Pongkemon01/Embedded-Thruster-Control-and-Monitor-System/README.md

# Embedded-Thruster-Control-and-Monitor-System
