Pongkemon01/Embedded-Thruster-Control-and-Monitor-System/circuit/etcam/etcam.kicad_pcb

## KiCad design circuit/etcam/etcam.kicad_pcb (2020-01-25)

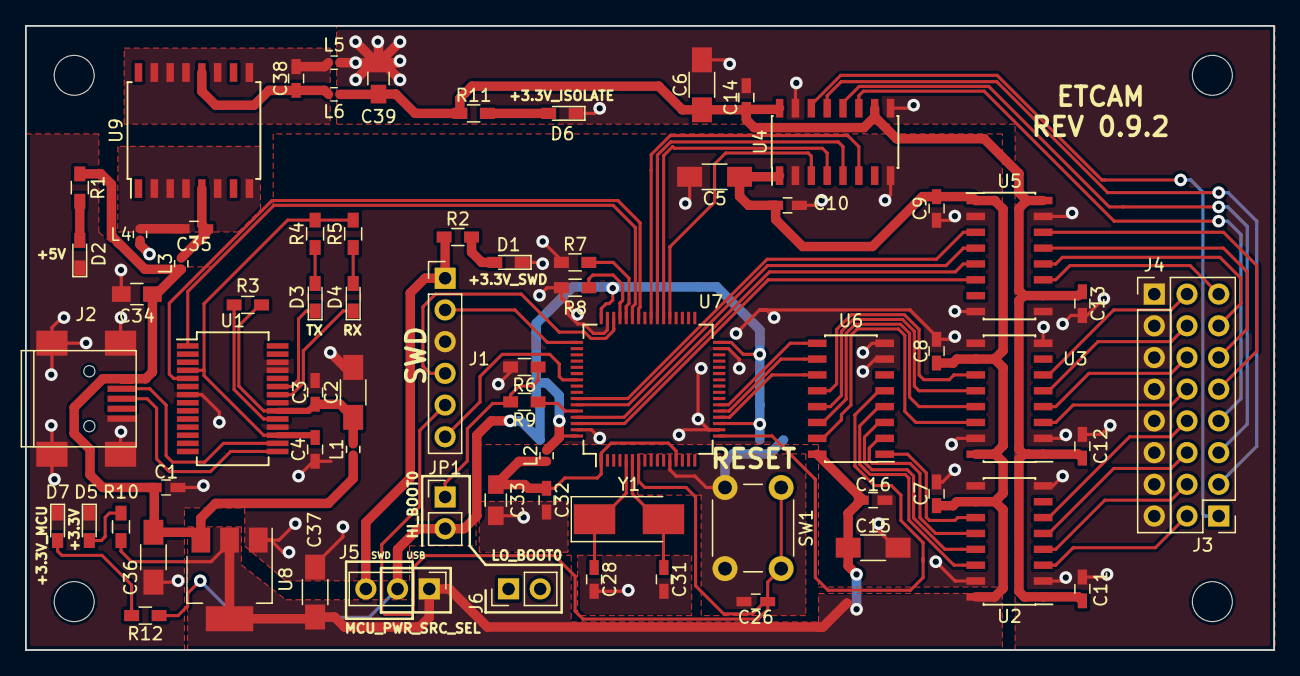
[picture p1: board etcam.kicad_pcb from above]

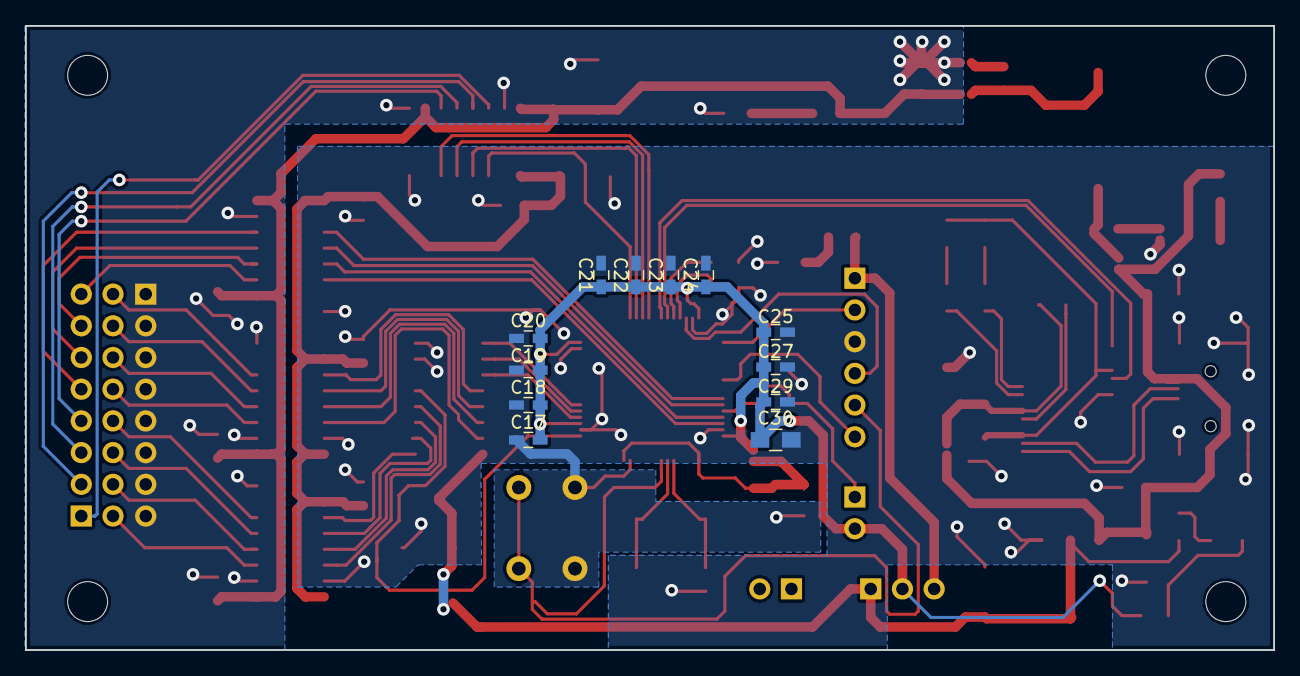
[picture p2: board etcam.kicad_pcb from below]

Board: 2 copper layers, 100.0 x 50.0 mm, 82 parts (12 on the bottom side), 74 nets.

Parts:
C1: 0.01uF; C_0603_HandSoldering
C2: 4.7uF; C_1206_HandSoldering
C3, C4, C7, C8, C9, C10, C11, C12, C13, C14, C16, C17, C18, C19, C20, C21, C22, C23, C24, C25, C26, C27, C29, C35: 0.1uF; C_0603_HandSoldering
C5, C6, C15: 1uF; C_1206_HandSoldering
C28, C31: 22pF; C_0603_HandSoldering
C30: 4.7uF; C_0805_HandSoldering
C32: 10nF; C_0603_HandSoldering
C33: 1uF; C_0805_HandSoldering
C34, C39: 10uF; C_0805_HandSoldering
C36, C37: 10uF; C_1206_HandSoldering
C38: 0.22uF; C_0603_HandSoldering
D1: +3.3V_SWD_LED; LED_0603_HandSoldering
D2: +5V_USB_LED; LED_0603_HandSoldering
D3: TX_LED; LED_0603_HandSoldering
D4: RX_LED; LED_0603_HandSoldering
D5: +3.3V_USB_LED; LED_0603_HandSoldering
D6: +3.3V_ISOLATOR_LED; LED_0603_HandSoldering
D7: +3.3V_CONTROLLER_LED; LED_0603_HandSoldering
J1: SWD_connector; Pin_Header_Straight_1x06_Pitch2.54mm
J2: USB_connector; USB_Mini-B
J3: ESC_signal_connector; Pin_Header_Straight_2x08_Pitch2.54mm
J4: ESC_GND_connector; Pin_Header_Straight_1x08_Pitch2.54mm
J5: MCU_PWR_SRC_selector; Pin_Header_Straight_1x03_Pitch2.54mm
J6: jumper_park; Pin_Header_Straight_1x02_Pitch2.54mm
JP1: BOOT_MODE_selector; Pin_Header_Straight_1x02_Pitch2.54mm
L1, L2, L3, L4, L5, L6: BLM15HD182SN1; L_0402
R1: 1k; R_0603_HandSoldering
R2, R4, R5, R10, R11, R12: 330; R_0603_HandSoldering
R3, R6, R7, R8, R9: 10k; R_0603_HandSoldering
SW1: reset_SW; SW_PUSH_6mm
U1: FT232RL; SSOP-28_5.3x10.2mm_Pitch0.65mm
U2, U3, U4, U5: Si8640BB-B-IS1; SOIC-16_3.9x9.9mm_Pitch1.27mm
U6: 74HC251; SOIC-16_3.9x9.9mm_Pitch1.27mm
U7: STM32F303xD/E-LQFP64; LQFP-64_10x10mm_Pitch0.5mm
U8: LM1117-3.3; SOT-223-3_TabPin2
U9: ADuM5020; SOIC-16W_7.5x10.3mm_Pitch1.27mm
Y1: 8MHz; Crystal_SMD_Abracon_ABM3-2pin_5.0x3.2mm_HandSoldering

Connections:
/+3.3V_ISOLATOR: C6.1, C11.1, C12.1, C13.1, C14.1, C39.1, L5.2, R11.1, U2.1, U3.1, U4.10, U4.16, U5.10, U5.16
/+3.3V_SWD: J1.1, J5.3, R2.1
/+3.3V_USB: C5.1, C7.1, C8.1, C9.1, C10.1, C15.1, C16.1, C37.1, J5.1, R10.1, U2.10, U2.16, U3.10, U3.16, U4.1, U5.1, U6.16, U8.2
/+5V_USB: C1.1, C34.1, C36.1, J2.1, L1.1, L3.1, R1.1, U8.3
/FTDI-->MCU: U1.1, U7.43
/FTDI<--MCU: U1.5, U7.42
/ISOLATED_DSHOT1: J3.1, U4.14
/ISOLATED_DSHOT2: J3.3, U4.13
/ISOLATED_DSHOT3: J3.5, U4.12
/ISOLATED_DSHOT4: J3.7, U4.11
/ISOLATED_DSHOT5: J3.9, U5.14
/ISOLATED_DSHOT6: J3.11, U5.13
/ISOLATED_DSHOT7: J3.13, U5.12
/ISOLATED_DSHOT8: J3.15, U5.11
/ISOLATED_TELEMETRY1: J3.2, U2.3
/ISOLATED_TELEMETRY2: J3.4, U2.4
/ISOLATED_TELEMETRY3: J3.6, U2.5
/ISOLATED_TELEMETRY4: J3.8, U2.6
/ISOLATED_TELEMETRY5: J3.10, U3.3
/ISOLATED_TELEMETRY6: J3.12, U3.4
/ISOLATED_TELEMETRY7: J3.14, U3.5
/ISOLATED_TELEMETRY8: J3.16, U3.6
/TDO_SWO: J1.6, U7.55
/TMS_SWCLK: J1.2, U7.49
/TMS_SWDIO: J1.4, U7.46
/controller/+3.3V_ANALOG: C32.1, C33.1, L2.2, U7.1, U7.13
/controller/+3.3V_CONTROLLER: C17.1, C18.1, C19.1, C20.1, C21.1, C22.1, C23.1, C24.1, C25.1, C27.1, C29.1, C30.1, J5.2, JP1.2, L2.1, R12.1, U7.19, U7.32, U7.48, U7.64
/controller/BOOT0: JP1.1, R6.1, R9.2
/controller/DSHOT1: U4.3, U7.37
/controller/DSHOT2: U4.4, U7.38
/controller/DSHOT3: U4.5, U7.39
/controller/DSHOT4: U4.6, U7.40
/controller/DSHOT5: U5.3, U7.58
/controller/DSHOT6: U5.4, U7.59
/controller/DSHOT7: U5.5, U7.61
/controller/DSHOT8: U5.6, U7.62
/controller/TELEMETRY_SEL0: U6.11, U7.20
/controller/TELEMETRY_SEL1: U6.10, U7.21
/controller/TELEMETRY_SEL2: U6.9, U7.22
/isolation_barrier/TELEMETRY1: U2.14, U6.4
/isolation_barrier/TELEMETRY2: U2.13, U6.3
/isolation_barrier/TELEMETRY3: U2.12, U6.2
/isolation_barrier/TELEMETRY4: U2.11, U6.1
/isolation_barrier/TELEMETRY5: U3.14, U6.15
/isolation_barrier/TELEMETRY6: U3.13, U6.14
/isolation_barrier/TELEMETRY7: U3.12, U6.13
/isolation_barrier/TELEMETRY8: U3.11, U6.12
/telementry_selector/SELECTED_TELEMETRY: U6.5, U7.17
/usb_to_serial/+3.3V_FTDI: C4.1, R4.2, R5.2, U1.4, U1.17
/usb_to_serial/+5V_FTDI: C2.1, C3.1, L1.2, R3.2, U1.20
/usb_to_serial/DM: J2.2, U1.16
/usb_to_serial/DP: J2.3, U1.15
/~RST: C26.1, J1.5, SW1.1, U7.7
GND: C1.2, C2.2, C3.2, C4.2, C5.2, C7.2, C8.2, C9.2, C10.2, C15.2, C16.2, C17.2, C18.2, C19.2, C20.2, C21.2, C22.2, C23.2, C24.2, C25.2, C26.2, C27.2, C28.2, C29.2, C30.2, C31.2, C32.2, C33.2, C34.2, C36.2, C37.2, D1.1, D2.1, D5.1, D7.1, J1.3, J2.5, J2.6, L4.1, R6.2, R7.1, R8.1, SW1.2, U1.7, U1.18, U1.21, U1.25, U1.26, U2.9, U2.15, U3.9, U3.15, U4.2, U4.8, U5.2, U5.8, U6.7, U6.8, U7.12, U7.18, U7.31, U7.47, U7.63, U8.1
GNDPWR: C6.2, C11.2, C12.2, C13.2, C14.2, C39.2, D6.1, J4.1, J4.2, J4.3, J4.4, J4.5, J4.6, J4.7, J4.8, L6.2, U2.2, U2.8, U3.2, U3.8, U4.9, U4.15, U5.9, U5.15
unnamed: C28.1, U7.5, Y1.1
unnamed: C31.1, U7.6, Y1.2
unnamed: C35.1, L3.2, U9.5
unnamed: C35.2, L4.2, U9.2, U9.3, U9.4, U9.6, U9.8
unnamed: C38.1, L5.1, U9.12
unnamed: C38.2, L6.1, U9.9, U9.11, U9.13, U9.14, U9.15
unnamed: D1.2, R2.2
unnamed: D2.2, R1.2
unnamed: D3.1, U1.23
unnamed: D3.2, R4.1
unnamed: D4.1, U1.22
unnamed: D4.2, R5.1
unnamed: D5.2, R10.2
unnamed: D6.2, R11.2
unnamed: D7.2, R12.2
unnamed: R3.1, U1.19
unnamed: R7.2, U7.44
unnamed: R8.2, U7.45
unnamed: R9.1, U7.60
