Pongkemon01/Embedded-Thruster-Control-and-Monitor-System/code/firmware/src/interrupt.c

#include "main.h"
#include "task_command.h"

extern UART_HandleTypeDef   x_uart_command_handle,
                            x_uart_telemetry_handler;
extern TIM_HandleTypeDef    x_tim3_handle,
                            x_tim4_handle,
                            x_tim8_handle,
                            x_tim16_handle;
extern SemaphoreHandle_t    x_semaphore_uart_command_rx_ready_handle,
                            x_semaphore_uart_telemetry_rx_ready_handle,
                            x_semaphore_uart_telemetry_tx_complete_handle,
                            x_semaphore_tim8_ch1_pulse_complete_handle,
                            x_semaphore_tim8_ch2_pulse_complete_handle,
                            x_semaphore_tim3_ch3_pulse_complete_handle,
                            x_semaphore_tim8_ch4_pulse_complete_handle,
                            x_semaphore_tim4_ch1_pulse_complete_handle,
                            x_semaphore_tim4_ch2_pulse_complete_handle,
                            x_semaphore_tim16_ch1_pulse_complete_handle,
                            x_semaphore_tim8_ch3_pulse_complete_handle;

void HAL_UART_TxCpltCallback( UART_HandleTypeDef *huart )
{
    BaseType_t x_higher_priority_task_woken = pdFALSE;

    if( huart->Instance == USART1 )
    {
        if( xSemaphoreGiveFromISR( x_semaphore_uart_telemetry_tx_complete_handle, &x_higher_priority_task_woken ) != pdTRUE )
        {
            // this line should call v_error_handler(),
            // but there is a bug that sometime x_semaphore_uart_telemetry_tx_complete_handle hold a semaphore when it not suppose to
            // cause the firmware to stuck when it not suppose to
        }
    }
    
    portYIELD_FROM_ISR( x_higher_priority_task_woken );
}

void HAL_UART_RxCpltCallback( UART_HandleTypeDef *huart )
{
    BaseType_t x_higher_priority_task_woken = pdFALSE;

    if( huart->Instance == USART1 )
    {
        if( xSemaphoreGiveFromISR( x_semaphore_uart_command_rx_ready_handle, &x_higher_priority_task_woken ) != pdTRUE )
        {
            v_error_handler();
        }
    }
    else if( huart->Instance == USART2 )
    {
        if( xSemaphoreGiveFromISR( x_semaphore_uart_telemetry_rx_ready_handle, &x_higher_priority_task_woken ) != pdTRUE )
        {
            v_error_handler();
        }
    }

    portYIELD_FROM_ISR( x_higher_priority_task_woken );
}

void HAL_TIM_PWM_PulseFinishedCallback( TIM_HandleTypeDef *htim )
{
    BaseType_t x_higher_priority_task_woken = pdFALSE;

    if( htim->Instance == TIM3 )
    {
        if( xSemaphoreGiveFromISR( x_semaphore_tim3_ch3_pulse_complete_handle, &x_higher_priority_task_woken ) != pdTRUE )
        {
            v_error_handler();
        }
    }
    else if( htim->Instance == TIM4 )
    {
        if( htim->Channel == HAL_TIM_ACTIVE_CHANNEL_1 )
        {
            if( xSemaphoreGiveFromISR( x_semaphore_tim4_ch1_pulse_complete_handle, &x_higher_priority_task_woken ) != pdTRUE )
            {
                v_error_handler();
            }
        }
        else if( htim->Channel == HAL_TIM_ACTIVE_CHANNEL_2 )
        {
            if( xSemaphoreGiveFromISR( x_semaphore_tim4_ch2_pulse_complete_handle, &x_higher_priority_task_woken ) != pdTRUE )
            {
                v_error_handler();
            }
        }
    }
    else if( htim->Instance == TIM8 )
    {
        if( htim->Channel == HAL_TIM_ACTIVE_CHANNEL_1 )
        {
            if( xSemaphoreGiveFromISR( x_semaphore_tim8_ch1_pulse_complete_handle, &x_higher_priority_task_woken ) != pdTRUE )
            {
                v_error_handler();
            }
        }
        else if( htim->Channel == HAL_TIM_ACTIVE_CHANNEL_2 )
        {
            if( xSemaphoreGiveFromISR( x_semaphore_tim8_ch2_pulse_complete_handle, &x_higher_priority_task_woken ) != pdTRUE )
            {
                v_error_handler();
            }
        }
        else if( htim->Channel == HAL_TIM_ACTIVE_CHANNEL_3 )
        {
            if( xSemaphoreGiveFromISR( x_semaphore_tim8_ch3_pulse_complete_handle, &x_higher_priority_task_woken ) != pdTRUE )
            {
                v_error_handler();
            }
        }
        else if( htim->Channel == HAL_TIM_ACTIVE_CHANNEL_4 )
        {
            if( xSemaphoreGiveFromISR( x_semaphore_tim8_ch4_pulse_complete_handle, &x_higher_priority_task_woken ) != pdTRUE )
            {
                v_error_handler();
            }
        }
    }
    else if( htim->Instance == TIM16 )
    {
        if( htim->Channel == HAL_TIM_ACTIVE_CHANNEL_1 )
        {
            if( xSemaphoreGiveFromISR( x_semaphore_tim16_ch1_pulse_complete_handle, &x_higher_priority_task_woken ) != pdTRUE )
            {
                v_error_handler();
            }
        }
    }

    portYIELD_FROM_ISR( x_higher_priority_task_woken );
}

void USART1_IRQHandler( void )
{
    HAL_UART_IRQHandler( &x_uart_command_handle );
}

void USART2_IRQHandler( void )
{
    HAL_UART_IRQHandler( &x_uart_telemetry_handler );
}

void DMA1_Channel1_IRQHandler( void )
{
    HAL_DMA_IRQHandler( x_tim4_handle.hdma[TIM_DMA_ID_CC1] );
}

void DMA1_Channel2_IRQHandler( void )
{
    HAL_DMA_IRQHandler( x_tim3_handle.hdma[TIM_DMA_ID_CC3] );
}

void DMA1_Channel3_IRQHandler( void )
{
    HAL_DMA_IRQHandler( x_tim16_handle.hdma[TIM_DMA_ID_CC1] );
}

void DMA1_Channel4_IRQHandler( void )
{
    HAL_DMA_IRQHandler( x_tim4_handle.hdma[TIM_DMA_ID_CC2] );
}

void DMA1_Channel5_IRQHandler( void )
{
    HAL_DMA_IRQHandler( x_uart_command_handle.hdmarx );
}

void DMA1_Channel6_IRQHandler( void )
{
    HAL_DMA_IRQHandler( x_uart_telemetry_handler.hdmarx );
}

void DMA2_Channel1_IRQHandler( void )
{
    HAL_DMA_IRQHandler( x_tim8_handle.hdma[TIM_DMA_ID_CC3] );
}
void DMA2_Channel2_IRQHandler( void )
{
    HAL_DMA_IRQHandler( x_tim8_handle.hdma[TIM_DMA_ID_CC4] );
}
void DMA2_Channel3_IRQHandler( void )
{
    HAL_DMA_IRQHandler( x_tim8_handle.hdma[TIM_DMA_ID_CC1] );
}
void DMA2_Channel5_IRQHandler( void )
{
    HAL_DMA_IRQHandler( x_tim8_handle.hdma[TIM_DMA_ID_CC2] );
}
