Pongkemon01/Embedded-Thruster-Control-and-Monitor-System/code/firmware/include/task_telemetry.h

#ifndef TASK_TELEMETRY_H
#define TASK_TELEMETRY_H

#include "main.h"

void v_task_telemetry_handler( void *pv_parameters );
void v_task_telemetry_trasmitter( void *pv_parameters );

extern UART_HandleTypeDef   x_uart_telemetry_handler;
extern QueueHandle_t        x_queue_telemetry_channel_handler;
extern SemaphoreHandle_t    x_semaphore_uart_telemetry_rx_ready_handle,
                            x_semaphore_uart_telemetry_tx_complete_handle,
                            x_semaphore_telemetry_handle;

#endif
