Pongkemon01/Embedded-Thruster-Control-and-Monitor-System/(commit log)

2018-11-27 init Embedded-Thruster-Control-and-Monitor-System repository
2018-11-27 added gitignore for KiCad
2018-11-29 init ETCAM_for_nucleo_32 KiCad project
    [etcam_for_nucleo_32.kicad_pcb, etcam_for_nucleo_32.sch]
2018-11-30 added Nucleo-32 and 74HC251 to etcam_for_nucleo_32
    [etcam_for_nucleo_32.sch]
2018-11-30 added digital isolators into ETCAM_for_Nucleo_32
    [etcam_for_nucleo_32.sch]
2018-11-30 annotated ETCAM_for_Nucleo_32 and fixed error from ERC
    [etcam_for_nucleo_32.sch]
2018-11-30 added footprints to components in ETCAM_for_Nucleo_32
    [etcam_for_nucleo_32.sch]
2018-11-30 created Nucleo-32 footprint and added etcam.pretty
2018-11-30 added ETCAM footprint lib to ETCAM_for_Nucleo_32
2018-11-30 fixed pin number of Nucleo-32 footprint
2018-11-30 fixed Nucleo-32 component pin number and footprint
    [etcam_for_nucleo_32.sch]
2018-11-30 changed 'ETCAM_lib' to 'ETCAM'
    [etcam_for_nucleo_32.sch]
2018-12-01 deleted silk mark on Nucleo-32 footprint
2018-12-01 fixed Nucleo-32 footprint using Nucleo-32 mechanical drawing
2018-12-01 moved 'REF**' of Nucleo-32 footprint
2018-12-01 added pin headers to ESCs
    [etcam_for_nucleo_32.sch]
2018-12-01 changed 'ESC' labels to 'DSHOT'
    [etcam_for_nucleo_32.sch]
2018-12-01 changed name of pin headers to ESCs
    [etcam_for_nucleo_32.sch]
2018-12-18 added ADuM5020 to ETCAM_for_Nucleo_32
    [etcam_for_nucleo_32.sch]
2018-12-18 added 1uF tantalum capacitors and changed 10uF footprint to 0805
    [etcam_for_nucleo_32.sch]
2018-12-18 annotated ETCAM_for_Nucleo_32
    [etcam_for_nucleo_32.sch]
2019-04-16 moved kicad-lib and schematic directory to circuit/
    [etcam_for_nucleo_32.kicad_pcb, etcam_for_nucleo_32.sch]
2019-04-16 added etcam kicad project
    [etcam.kicad_pcb, etcam.sch]
2019-04-16 added STM32F303xD/E-LQFN64 component symbol to etcam library
2019-04-16 changed "NRST" pin name on STM32F303*D/E-LQFP64 symbol to "RST" with bar
2019-04-16 added FT232RL and completed power supply part for FT232RL and STM32F303xD/E
    [etcam.sch]
2019-04-17 completed pin layout on STM32F303xD/E in ETCAM
    [etcam.sch]
2019-04-17 added JTAG pin to STM32F303xD/E in ETCAM
    [etcam.sch]
2019-04-17 changed JTAG to SWD and added SWD connector in ETCAM
    [etcam.sch]
2019-04-18 simplified boot mode circuit
    [etcam.sch]
2019-04-18 made usb_to_serial circuit and controller circuit into separate sheet
    [controller.sch, etcam.sch, usb_to_serial.sch]
2019-04-18 added isolation_barrier and telementry_selector to ETCAM
    [controller.sch, dc_dc_converter.sch, etcam.sch, isolation_barrier.sch, telementry_selector.sch, usb_to_serial.sch]
2019-04-18 rearrage symbols in isolation_barrier of ETCAM
    [etcam.sch, isolation_barrier.sch]
2019-04-18 changed 100nF to 0.1uF in ETCAM
    [controller.sch, usb_to_serial.sch]
2019-04-18 assigned footprint to every component of ETCAM
    [controller.sch, dc_dc_converter.sch, etcam.sch, isolation_barrier.sch, usb_to_serial.sch]
2019-04-18 annotated components in ETCAM
    [controller.sch, dc_dc_converter.sch, etcam.sch, isolation_barrier.sch, telementry_selector.sch, usb_to_serial.sch]
2019-04-18 performed and corrected electrical rules check
    [controller.sch, dc_dc_converter.sch, etcam.sch, isolation_barrier.sch, telementry_selector.sch, usb_to_serial.sch]
2019-04-18 removed schematic_for_nucleo_32
    [etcam_for_nucleo_32.kicad_pcb, etcam_for_nucleo_32.sch]
2019-04-19 changed GND of reset_SW to GNDA in ETCAM
    [controller.sch]
2019-04-19 added revision number to schematic sheet of ETCAM
    [etcam.sch]
2019-04-19 configured pcb design rules of ETCAM
    [etcam.kicad_pcb]
2019-04-19 added LEDs to every power rail of ETCAM and re-annotated the schematic
    [controller.sch, dc_dc_converter.sch, etcam.kicad_pcb, etcam.sch, isolation_barrier.sch, telementry_selector.sch, usb_to_serial.sch]
2019-04-19 fixed USB-DP of STM32 don't connected to ground in ETCAM
    [controller.sch]
2019-04-20 added LED for +3.3V in controller schematic of ETCAM
    [controller.sch, dc_dc_converter.sch, etcam.sch, isolation_barrier.sch, telementry_selector.sch, usb_to_serial.sch]
2019-04-20 finished routing ETCAM PCB without GND
    [etcam.kicad_pcb]
2019-04-20 added mounting holes into ETCAM PCB
    [etcam.kicad_pcb]
2019-04-20 added descriptive silkskins to ETCAM PCB
    [etcam.kicad_pcb]
2019-04-20 added GND plane to ETCAM PCB
    [etcam.kicad_pcb]
2019-04-20 added via between front and back GND plane in ETCAM PCB
    [etcam.kicad_pcb]
2019-04-20 fixed +3.3V_ISOLATOR_LED grounded to GND in ETCAM
    [dc_dc_converter.sch]
2019-04-20 added GNDPWR pland to ETCAM PCB
    [etcam.kicad_pcb]
2019-04-20 fixed position of 3.3V_ISOLATOR_LED label in ETCAM PCB
    [etcam.kicad_pcb]
2019-04-20 added ETCAM description into PCB
    [etcam.kicad_pcb]
2019-04-20 fixed straight trace in ETCAM PCB
    [etcam.kicad_pcb]
2019-04-20 fixed U7 reference to front side in ETCAM PCB
    [etcam.kicad_pcb]
2019-04-21 moved .gitignore to circuit/
2019-04-21 init code of LED blink using FreeRTOS on NUCLEO-F303RE
2019-04-23 fixed "telementry" to "telemetry" in ETCAM
    [controller.sch, dc_dc_converter.sch, etcam.kicad_pcb, etcam.sch, isolation_barrier.sch, telementry_selector.sch]
2019-04-23 fixed +3.3V_ISOLATOR cut GND_PWR plane in ETCAM PCB
    [etcam.kicad_pcb]
2019-04-23 rearranged mounting holes of ETCAM PCB
    [etcam.kicad_pcb]
2019-04-24 fixed MCU_PWR_SRC_SEL silkskin in ETCAM PCB
    [etcam.kicad_pcb]
2019-04-24 moved passive components of FTDI more nearer
    [etcam.kicad_pcb]
2019-04-24 fixed TX_LED and RX_LED silkskin in ETCAM PCB
    [etcam.kicad_pcb]
2019-04-29 could receive command via UART using DMA
2019-04-29 could parse throttle command into throttle in code/
2019-04-29 refactored init and error handler functions in code/
    [init.c, interrupt.c, main.c, main.h, msp.c]
2019-04-30 fixed parameter name of msp init of uart in code/
    [msp.c]
2019-05-05 could make pulse from throttle command
2019-05-12 could write pulse to an IO pin
2019-05-13 changed thruster task tick rate into 1kHz
2019-05-13 removed led init function
2019-05-13 could write pulse on TIM4's IO pin in code/
2019-05-13 refactored uart initialization from main.c to init.c in code/
2019-05-13 refactored timer initialization from main.c to init.c in code/
2019-05-14 could write pulse on TIM8's pin in code/
2019-05-14 could write pulse on TIM16's pin in code/
2019-05-14 could transmit telemetry to control device in code/
2019-05-17 swaped role between USART1 and USART2 in /code
    [init.c, interrupt.c, msp.c]
2019-05-18 made throttle bit reversed before be packed DSHOT in /code
    [main.c]
2019-05-18 fixed name of const telemetry begin variable in code/
    [task_telemetry.c]
2019-05-19 made reverse_throttle_bit and generate_crc function inline in code/
    [main.c]
2019-05-24 added libetcam, driver for ETCAM, in code/
2019-05-25 used pass by ref instead of pass by value in function of driver/
2019-05-26 made class declaration of ETCAM driver legit
2019-05-26 quitted using thruster state word in code/
2019-05-26 fixed member data name of TelemetrySync class in driver/
2019-05-27 corrected telemetry voltage and current parsing in driver/
2019-05-27 fixed typo of TelemetryStruct.us_power_consumption in driver/
2019-06-03 corrected telemetry erpm parsing in driver/
2019-06-03 removed default value from TelemetryStruct and u_sync_count in driver/
2019-06-03 fixed u_sync_count_ typo in driver/
2019-06-15 fixed the firmware stuck randomly in firmware/
    [interrupt.c]
